edwin9532/Cap-Cal/README.md

# Cap-Cal
Project for automatization of heat capacity experiment, using arduino
