edwin9532/Cap-Cal/Main/data/data____.png

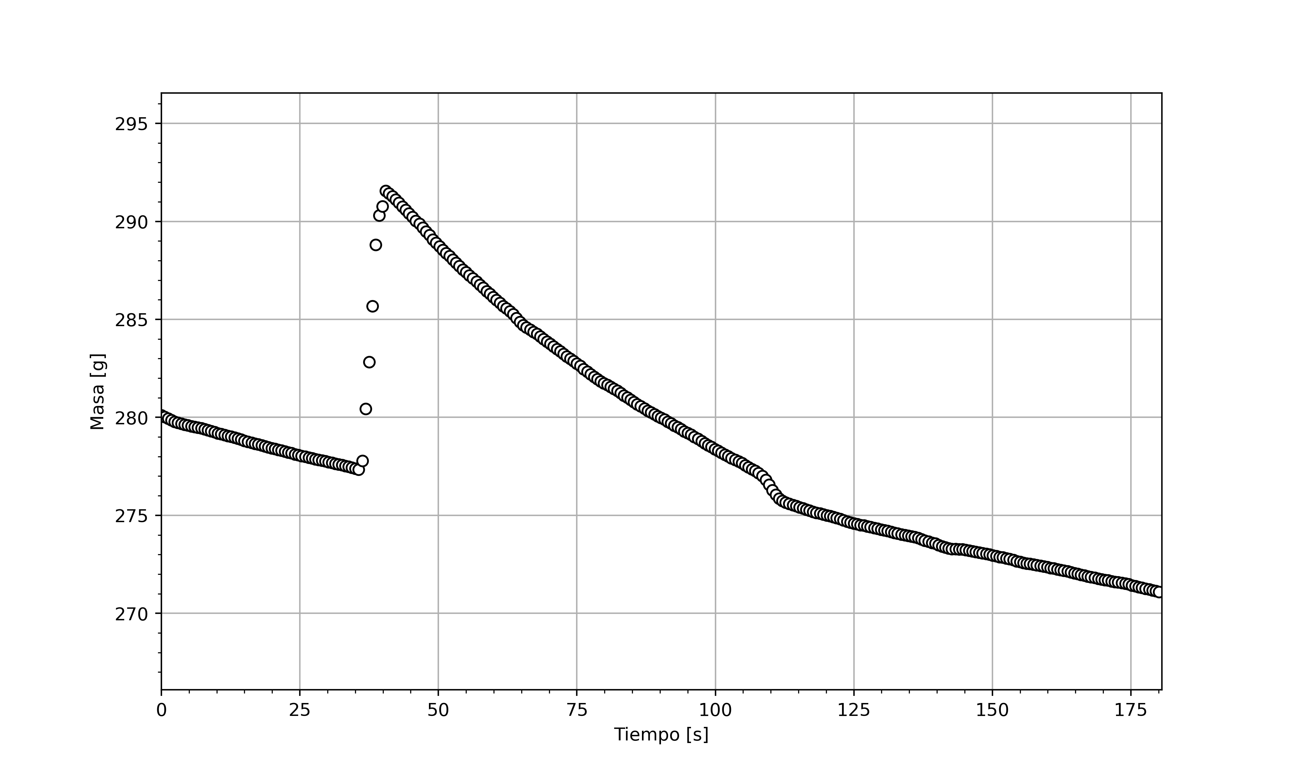
Main/data/data____.png
