edwin9532/Cap-Cal/Main/data/data_Al2.png

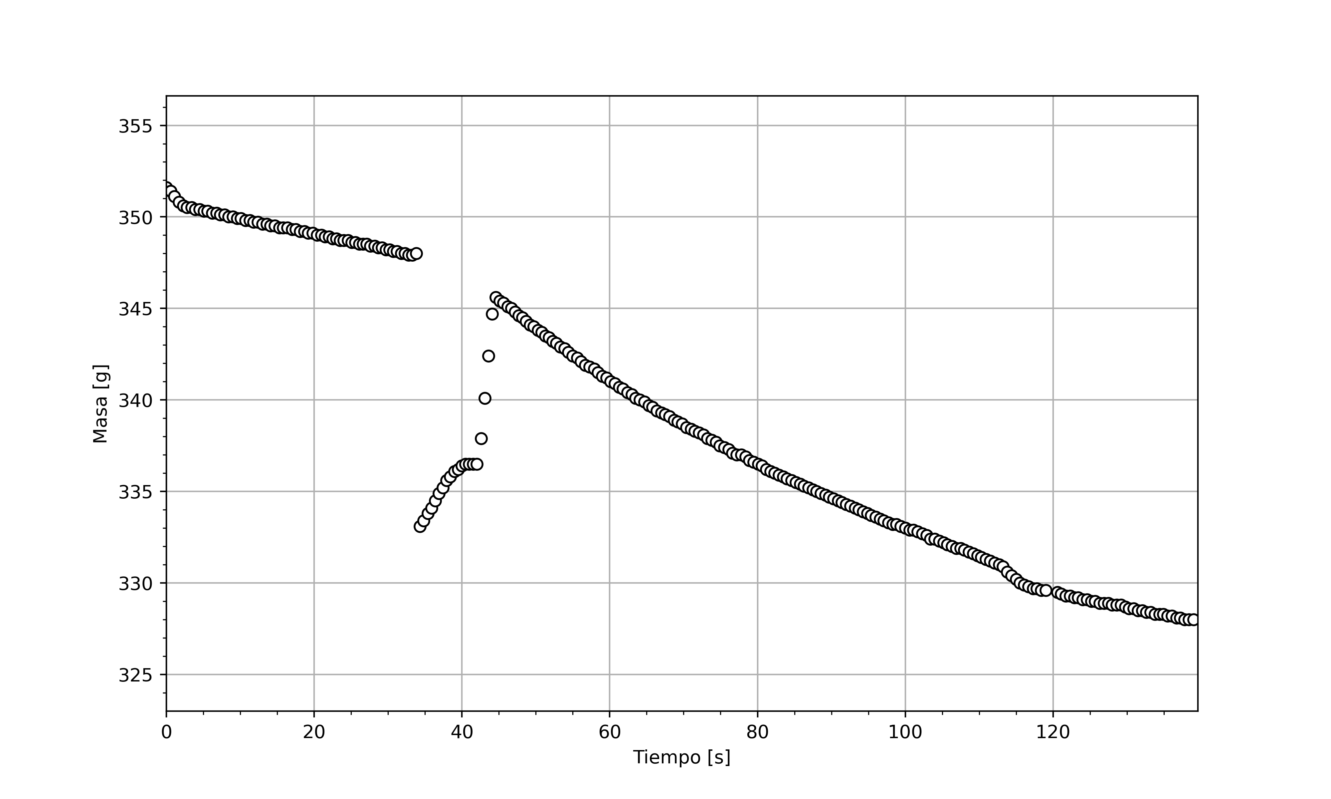
Main/data/data_Al2.png
