edwin9532/Cap-Cal/Main/data/data_Al.png

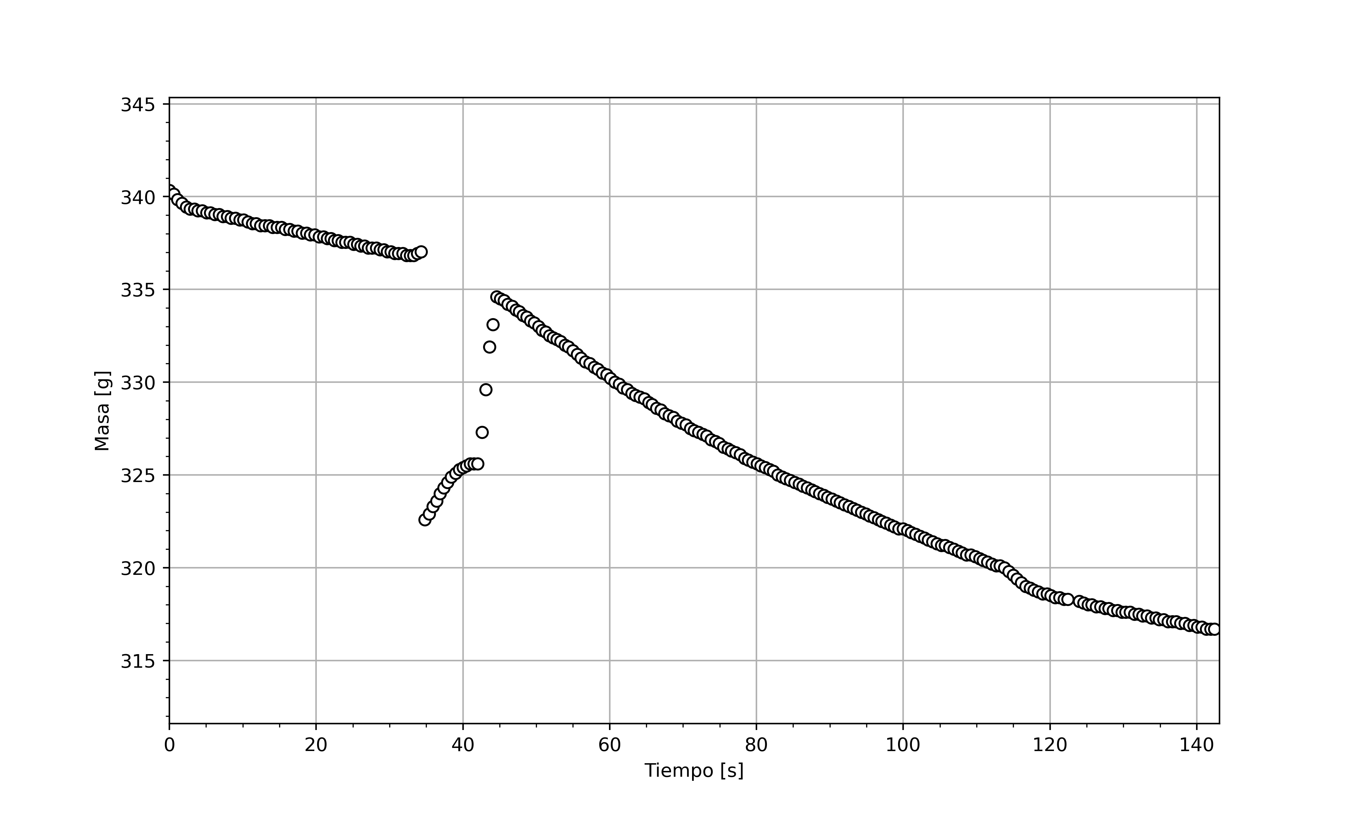
Main/data/data_Al.png
