edwin9532/Cap-Cal/Main/data/data_Cu2.png

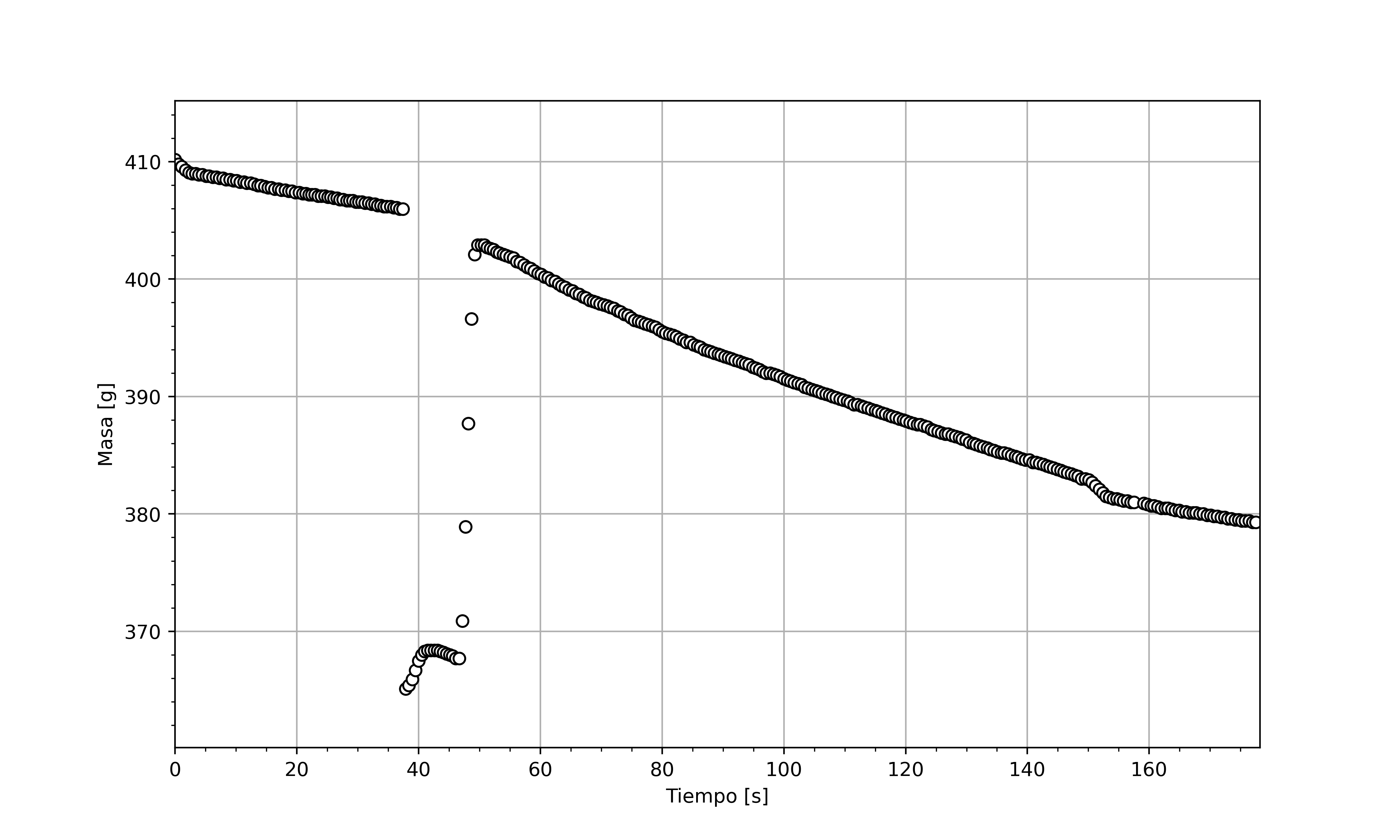
Main/data/data_Cu2.png
