edwin9532/Cap-Cal/Main/data/data_Cu.png

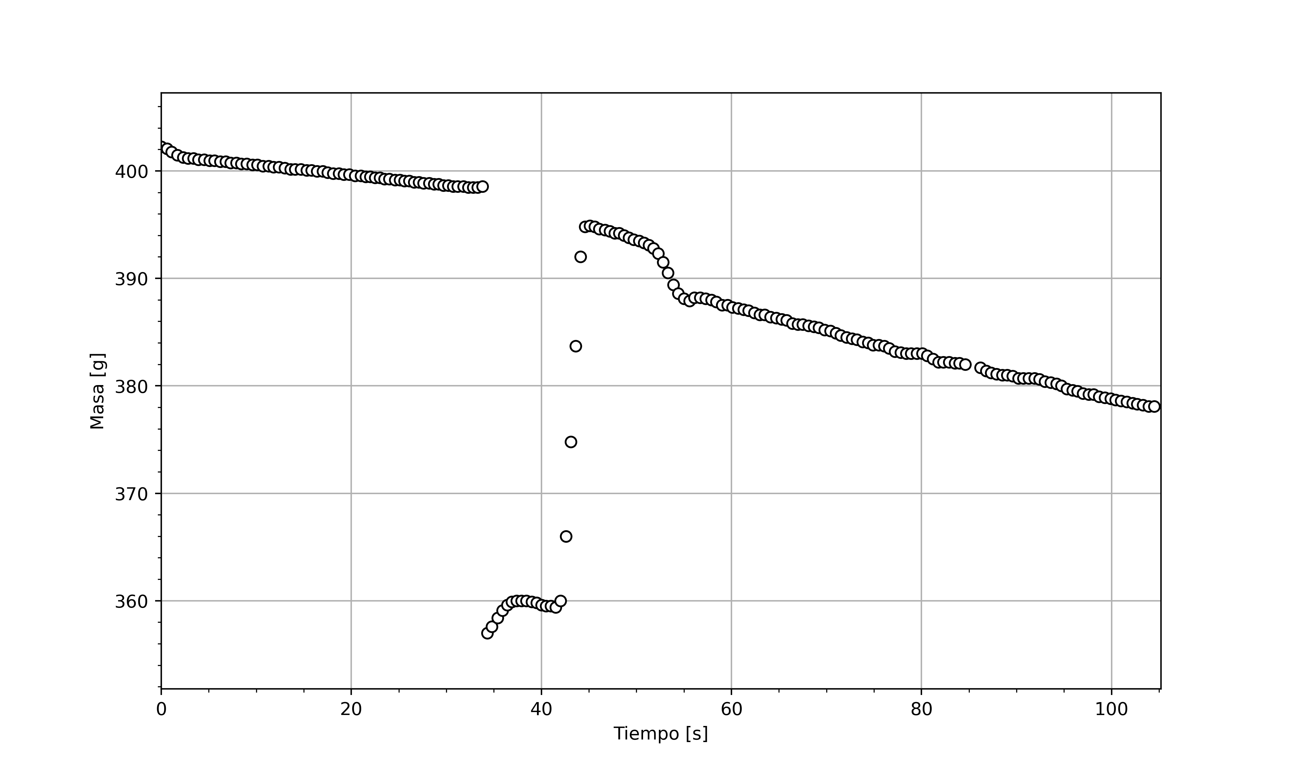
Main/data/data_Cu.png
