edwin9532/Cap-Cal/Main/data/data_Fe1.png

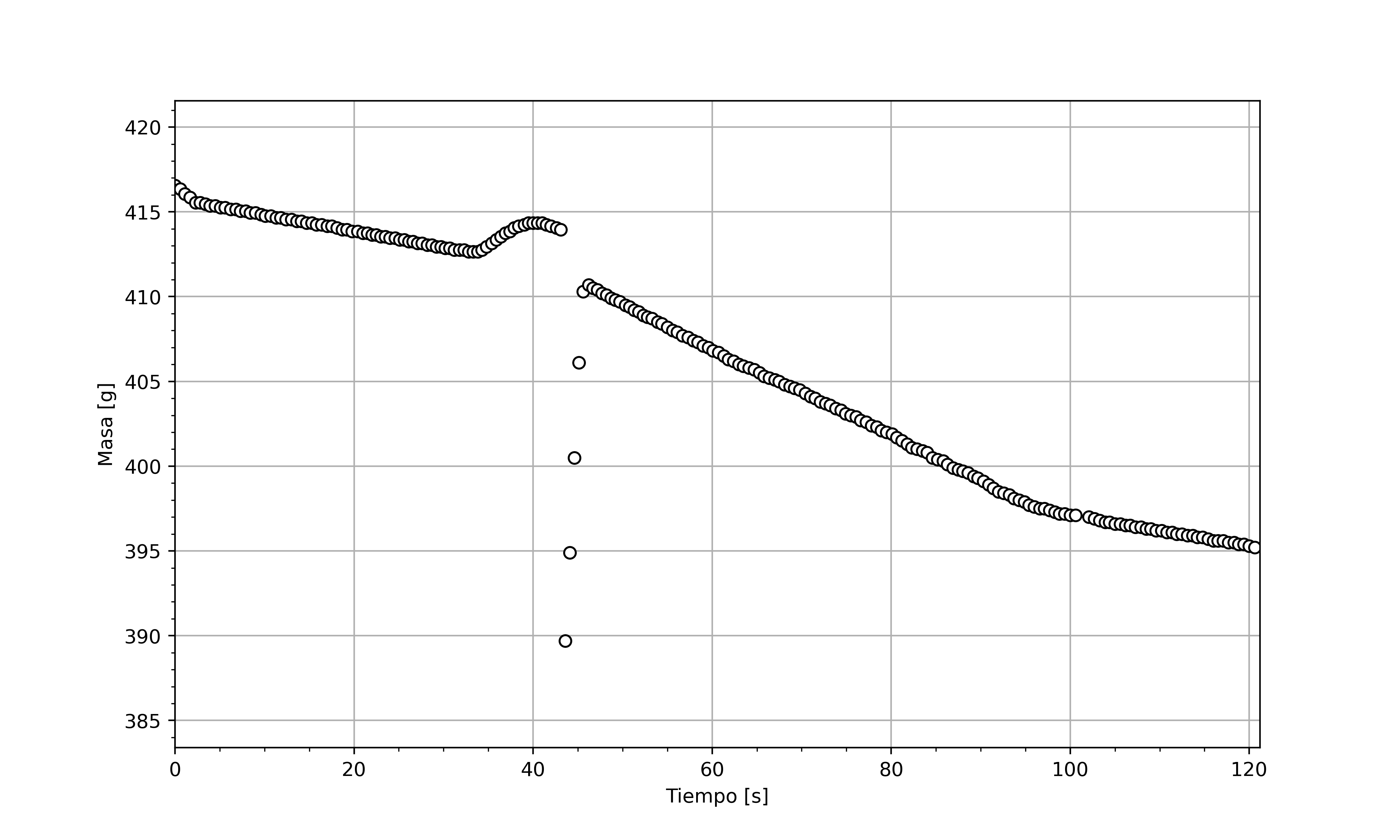
Main/data/data_Fe1.png
